ishita-parekh/EMGControlledHandExoskeleton/README.md

# EMGControlledHandExoskeleton
EMG controlled hand exoskeleton for rehabilitation of patients recovering from accidents or stroke

#Demonstartion youtube link: https://youtu.be/TVKU1VpVG2Y
