ishita-parekh/EMGControlledHandExoskeleton/Final_Hand_Exo/pusher-125mm-long.STL

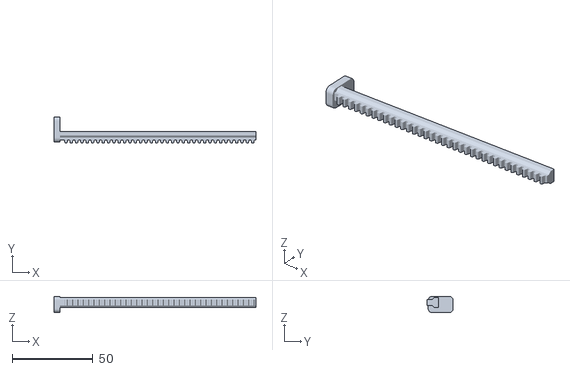
[picture p63: CAD file, 2019-08-11]
Final_Hand_Exo/pusher-125mm-long.STL
125.0 x 16.3 x 10.2
