ishita-parekh/EMGControlledHandExoskeleton/Final_Hand_Exo/RingFinger_LastBit.stl

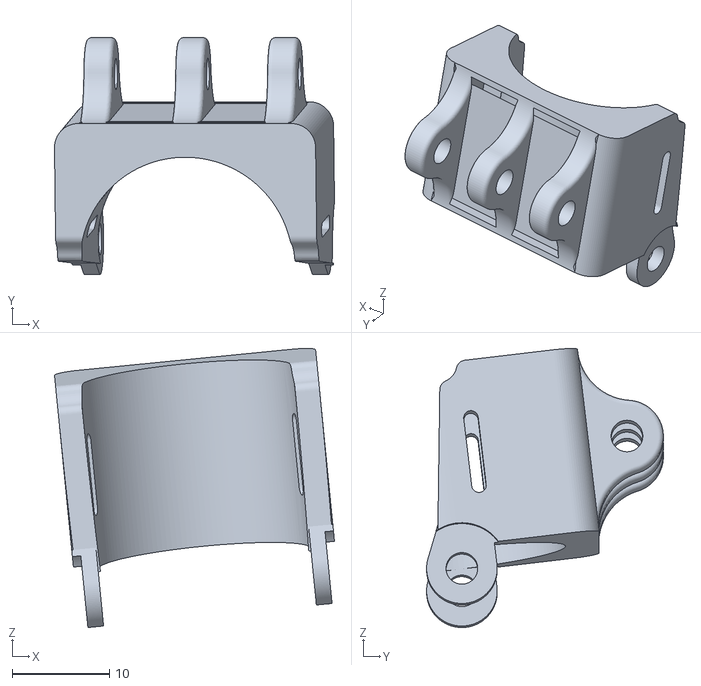
[picture p64: CAD file, 2019-08-11]
Final_Hand_Exo/RingFinger_LastBit.stl
28.8 x 24.4 x 28.7
