ishita-parekh/EMGControlledHandExoskeleton/Final_Hand_Exo/Back_HAnd_BAse_LittleFinger.stl

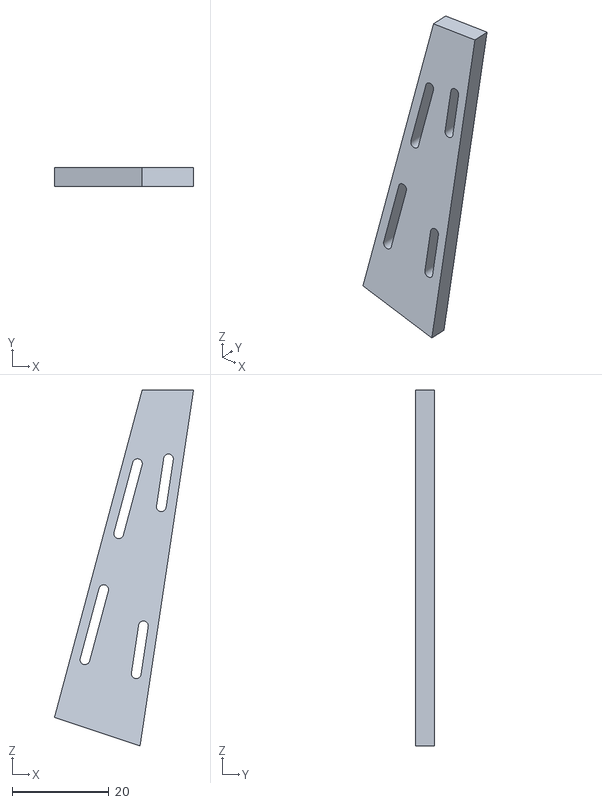
[picture p65: CAD file, 2019-08-11]
Final_Hand_Exo/Back_HAnd_BAse_LittleFinger.stl
28.7 x 4.00 x 73.5
