ishita-parekh/EMGControlledHandExoskeleton/Final_Hand_Exo/IndexFinger_Large4BarConnector.stl

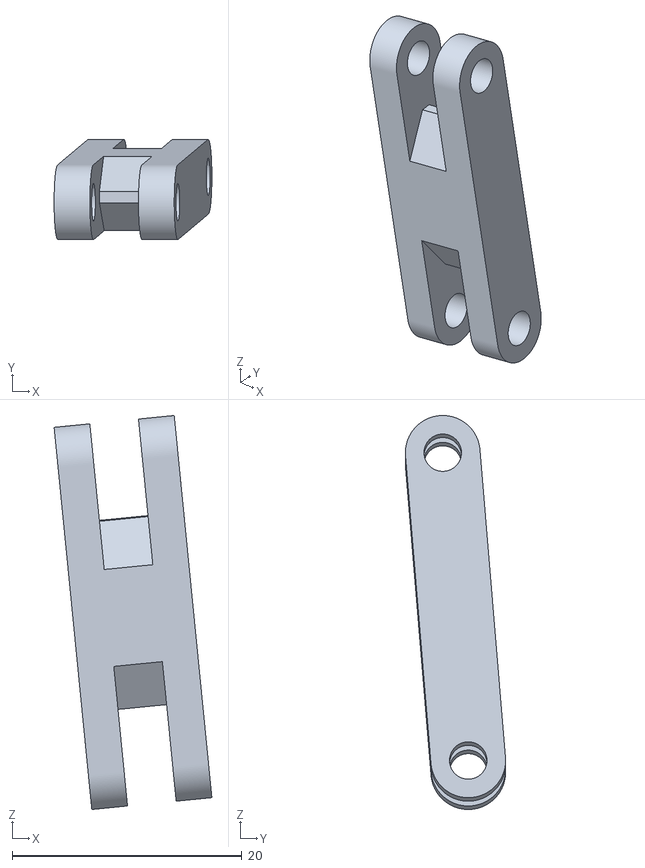
[picture p66: CAD file, 2019-08-11]
Final_Hand_Exo/IndexFinger_Large4BarConnector.stl
13.7 x 8.72 x 34.3
