ishita-parekh/EMGControlledHandExoskeleton/Final_Hand_Exo/RingFinger_FourBarConnector1.stl

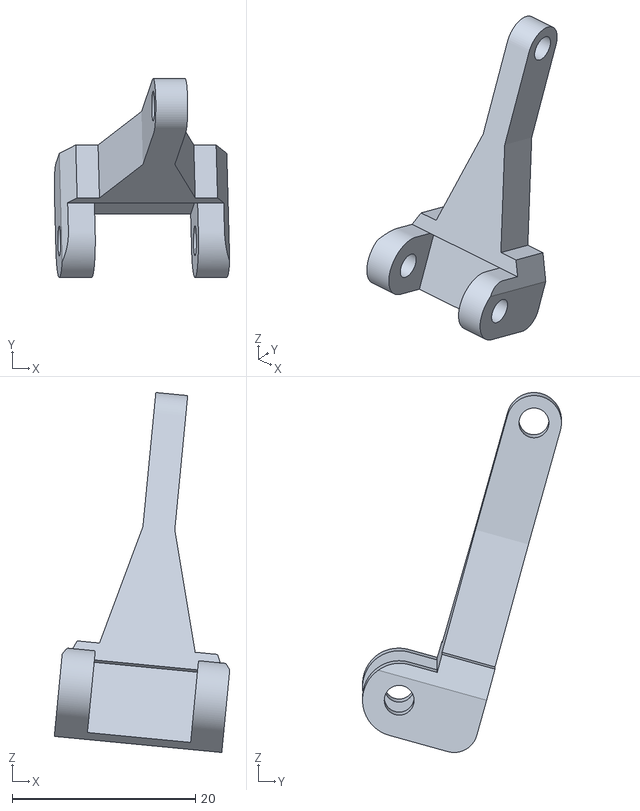
[picture p67: CAD file, 2019-08-11]
Final_Hand_Exo/RingFinger_FourBarConnector1.stl
19.2 x 21.7 x 39.3
