ishita-parekh/EMGControlledHandExoskeleton/Final_Hand_Exo/MiddleFinger_4BarConnectorLarge.stl

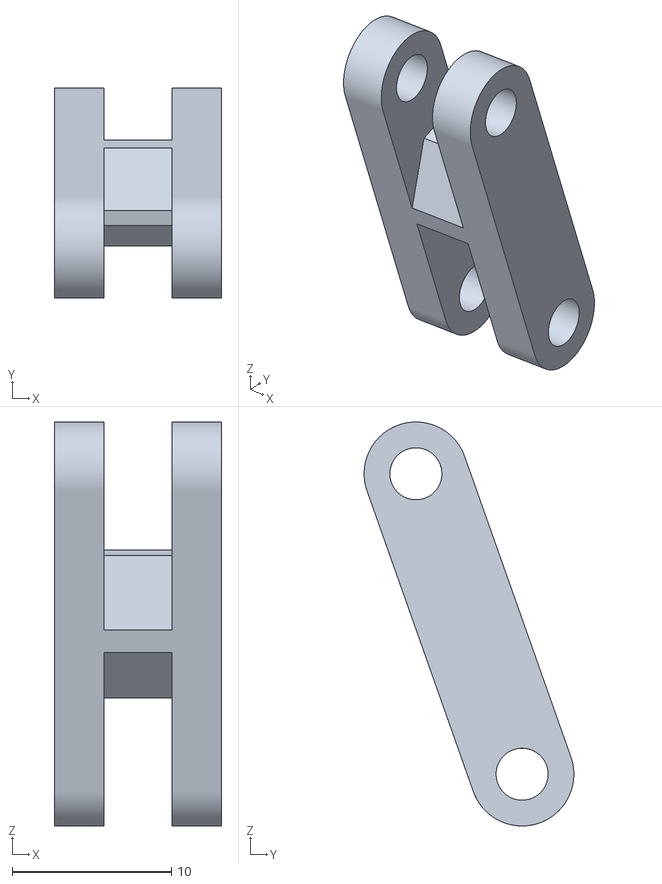
[picture p68: CAD file, 2019-08-11]
Final_Hand_Exo/MiddleFinger_4BarConnectorLarge.stl
10.5 x 13.2 x 25.4
