ishita-parekh/EMGControlledHandExoskeleton/Final_Hand_Exo/LittleFinger_LAstBit.stl

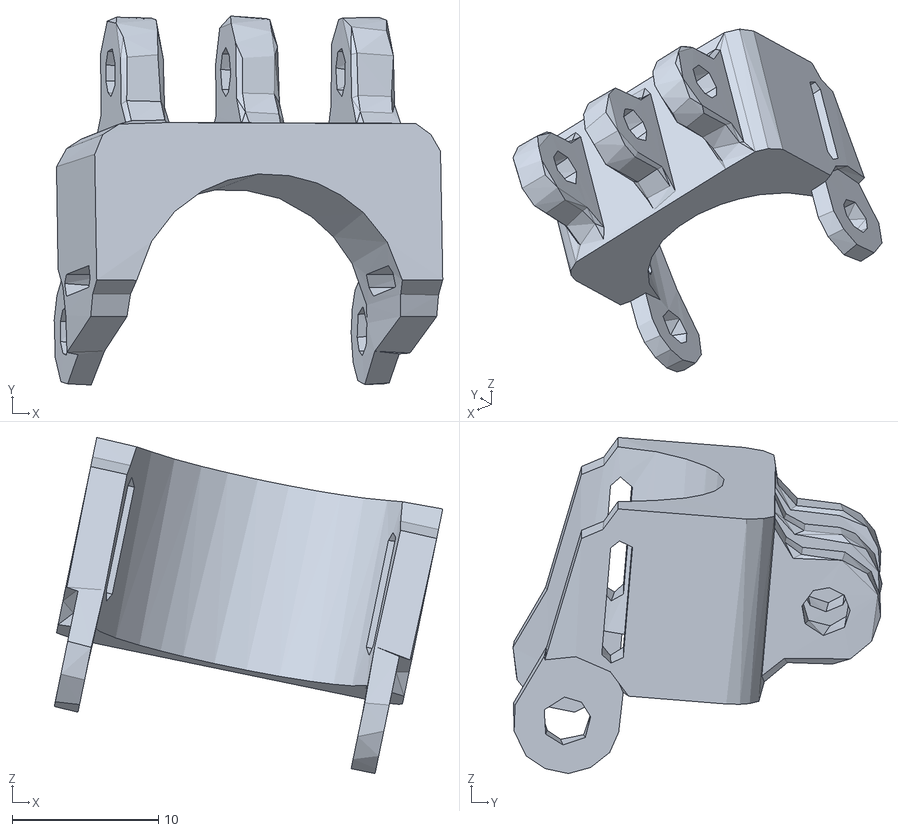
[picture p69: CAD file, 2019-08-11]
Final_Hand_Exo/LittleFinger_LAstBit.stl
26.6 x 25.3 x 23.0
