ishita-parekh/EMGControlledHandExoskeleton/Final_Hand_Exo/IndexFinger_fourBarConnector.stl

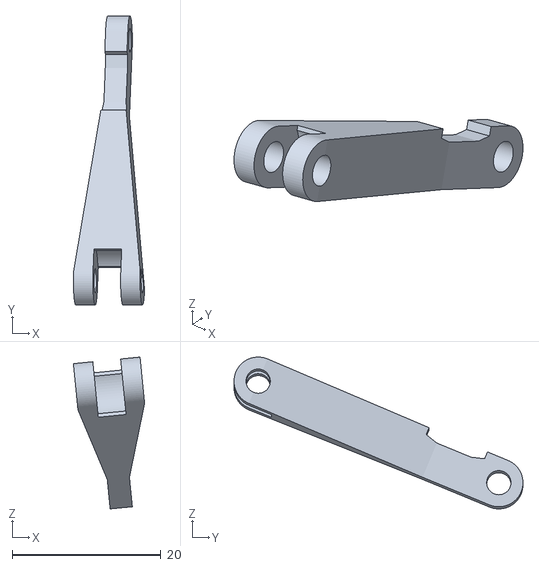
[picture p70: CAD file, 2019-08-11]
Final_Hand_Exo/IndexFinger_fourBarConnector.stl
9.57 x 38.8 x 20.4
