ishita-parekh/EMGControlledHandExoskeleton/Final_Hand_Exo/MiddleFinger_TipBit.stl

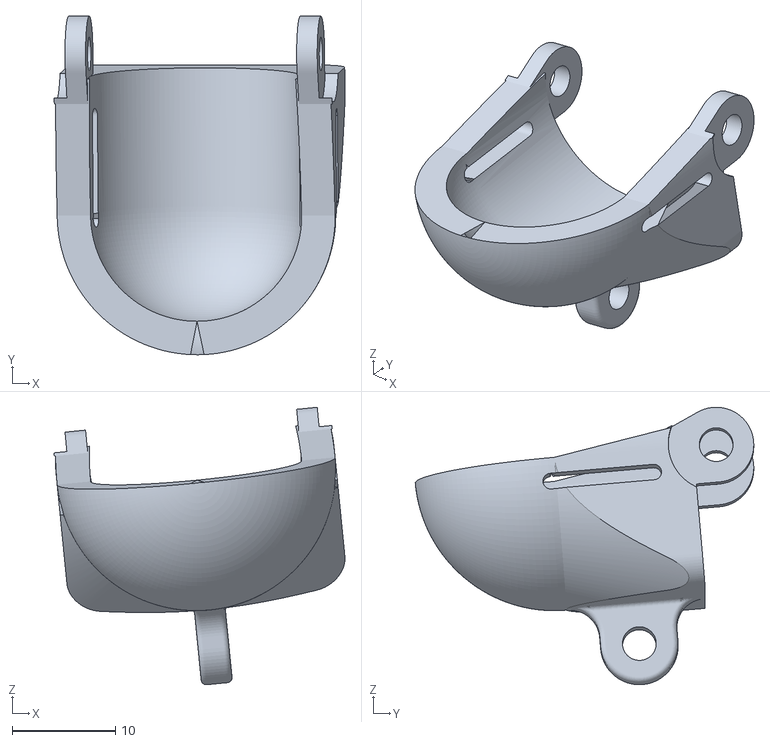
[picture p71: CAD file, 2019-08-11]
Final_Hand_Exo/MiddleFinger_TipBit.stl
28.1 x 32.7 x 26.8
