ishita-parekh/EMGControlledHandExoskeleton/Final_Hand_Exo/MiddleFinger_CentralBit.stl

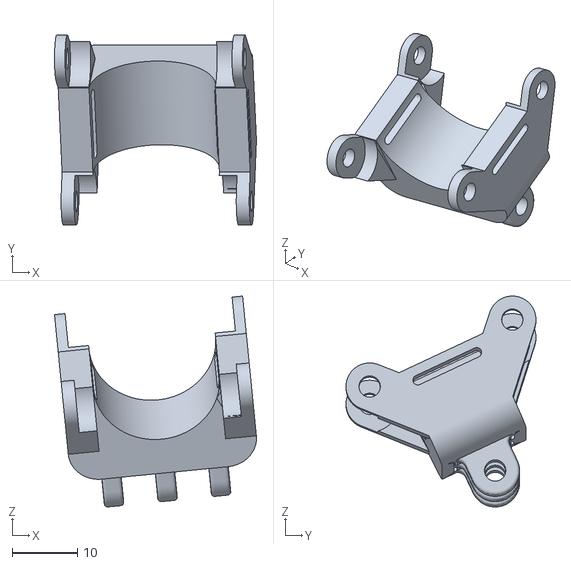
[picture p72: CAD file, 2019-08-11]
Final_Hand_Exo/MiddleFinger_CentralBit.stl
31.0 x 29.2 x 32.4
