ishita-parekh/EMGControlledHandExoskeleton/Final_Hand_Exo/IndexFinger_4BarConnector1.stl

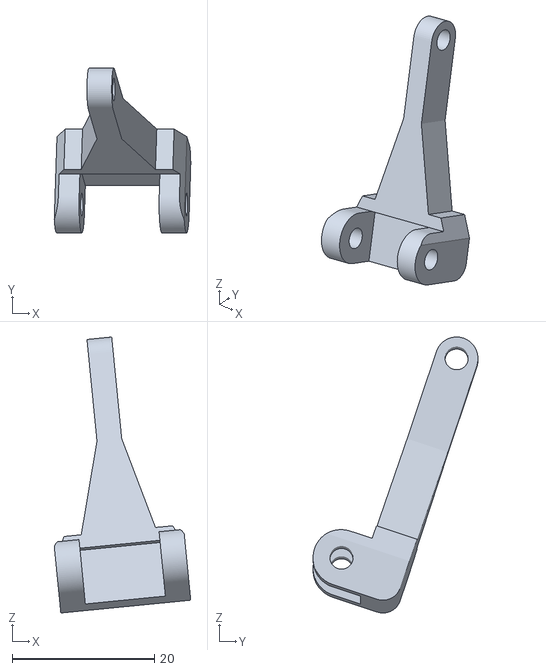
[picture p73: CAD file, 2019-08-11]
Final_Hand_Exo/IndexFinger_4BarConnector1.stl
19.2 x 23.2 x 38.8
