ishita-parekh/EMGControlledHandExoskeleton/Final_Hand_Exo/MiddleFinger_FourBarConnector.stl

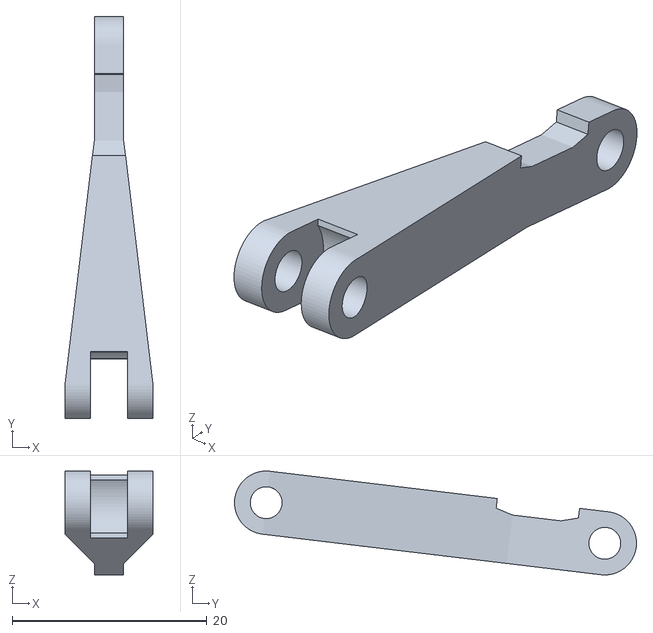
[picture p74: CAD file, 2019-08-11]
Final_Hand_Exo/MiddleFinger_FourBarConnector.stl
9.00 x 41.2 x 10.7
