ishita-parekh/EMGControlledHandExoskeleton/Final_Hand_Exo/Bar_HolderLastBit.stl

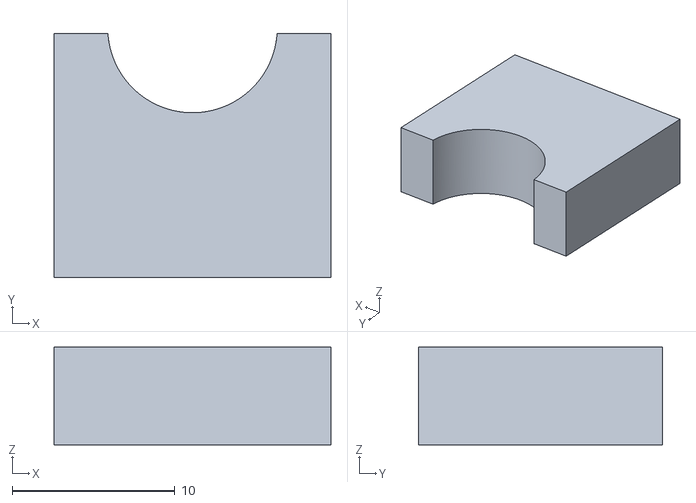
[picture p75: CAD file, 2019-08-11]
Final_Hand_Exo/Bar_HolderLastBit.stl
17.0 x 15.0 x 6.00
