ishita-parekh/EMGControlledHandExoskeleton/Final_Hand_Exo/LittleFinger_FourBArConnector1.stl

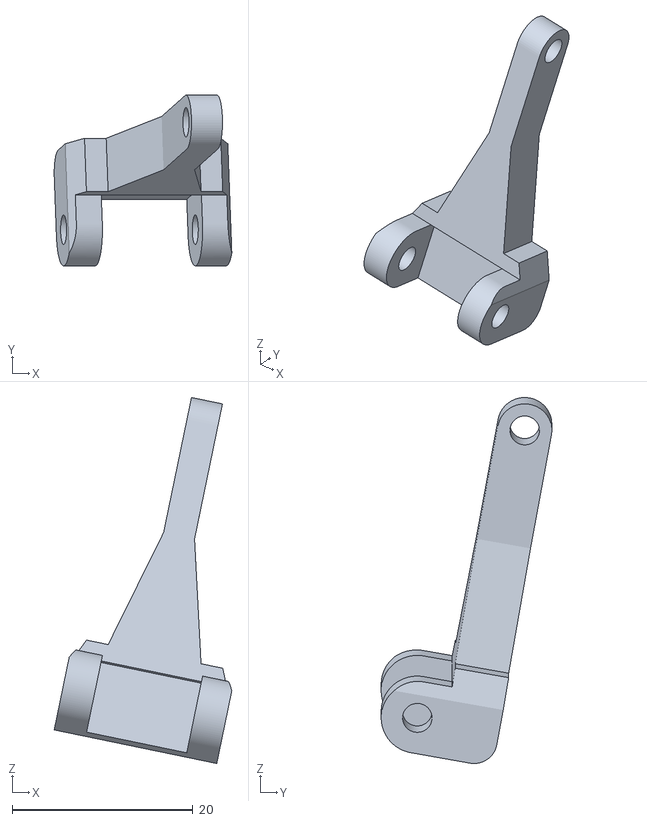
[picture p76: CAD file, 2019-08-11]
Final_Hand_Exo/LittleFinger_FourBArConnector1.stl
19.7 x 18.9 x 40.5
