ishita-parekh/EMGControlledHandExoskeleton/Final_Hand_Exo/Moto_To_ExoConnector.stl

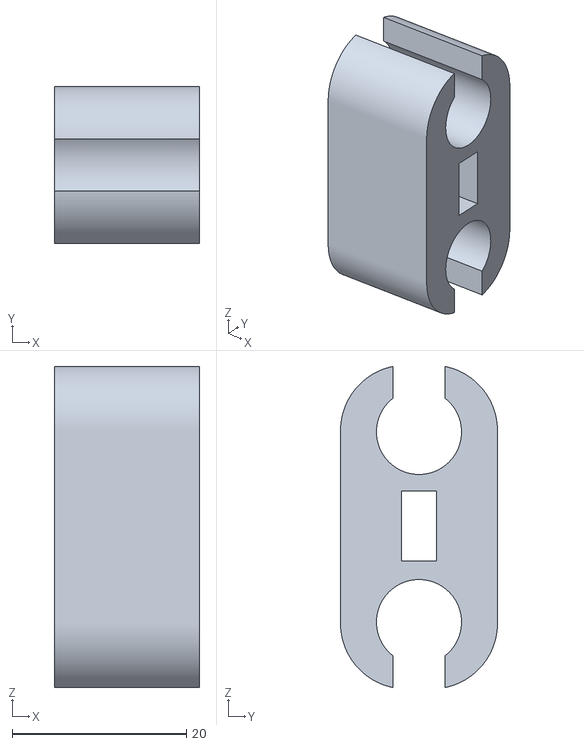
[picture p77: CAD file, 2019-08-11]
Final_Hand_Exo/Moto_To_ExoConnector.stl
16.7 x 18.0 x 36.8
