ishita-parekh/EMGControlledHandExoskeleton/Final_Hand_Exo/Outer_Rod.stl

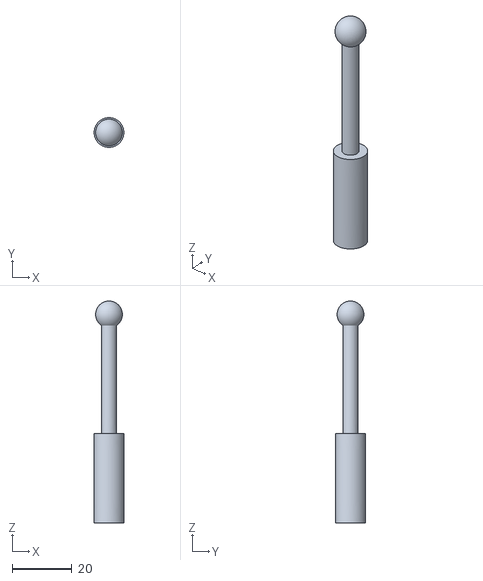
[picture p78: CAD file, 2019-08-11]
Final_Hand_Exo/Outer_Rod.stl
10.0 x 10.00 x 74.5
