ishita-parekh/EMGControlledHandExoskeleton/Final_Hand_Exo/pinion-gear-mini-version.STL

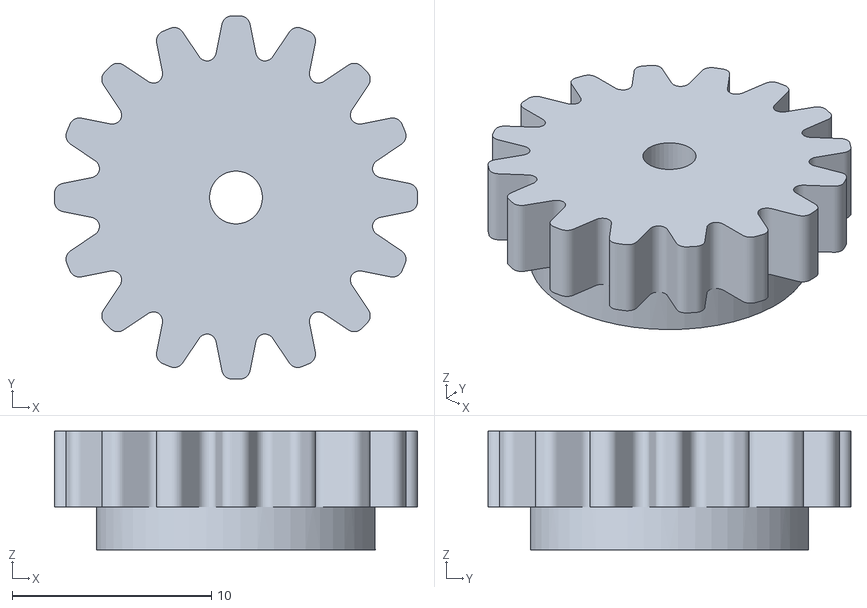
[picture p79: CAD file, 2019-08-11]
Final_Hand_Exo/pinion-gear-mini-version.STL
18.2 x 18.2 x 5.97
