ishita-parekh/EMGControlledHandExoskeleton/Final_Hand_Exo/RingFinger_FourBarConnectorMid.stl

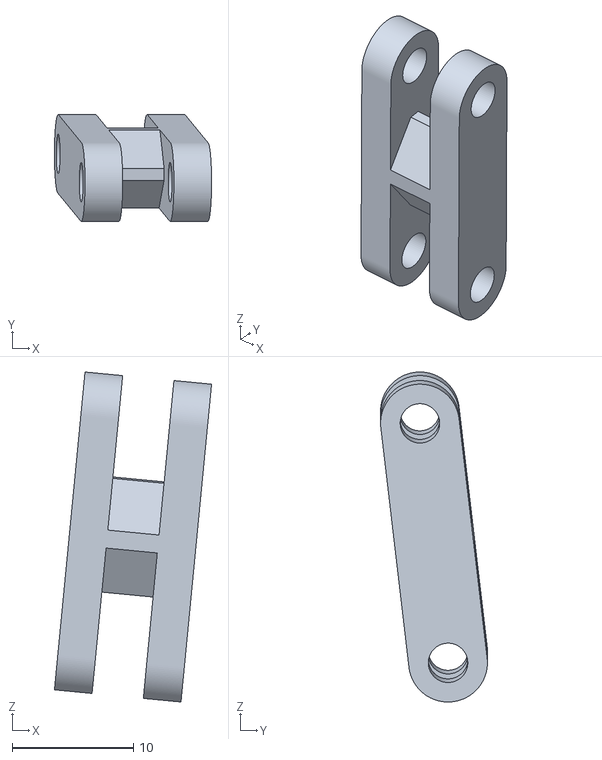
[picture p80: CAD file, 2019-08-11]
Final_Hand_Exo/RingFinger_FourBarConnectorMid.stl
13.0 x 8.82 x 27.2
