ishita-parekh/EMGControlledHandExoskeleton/Final_Hand_Exo/LittleFinger_TipBit.stl

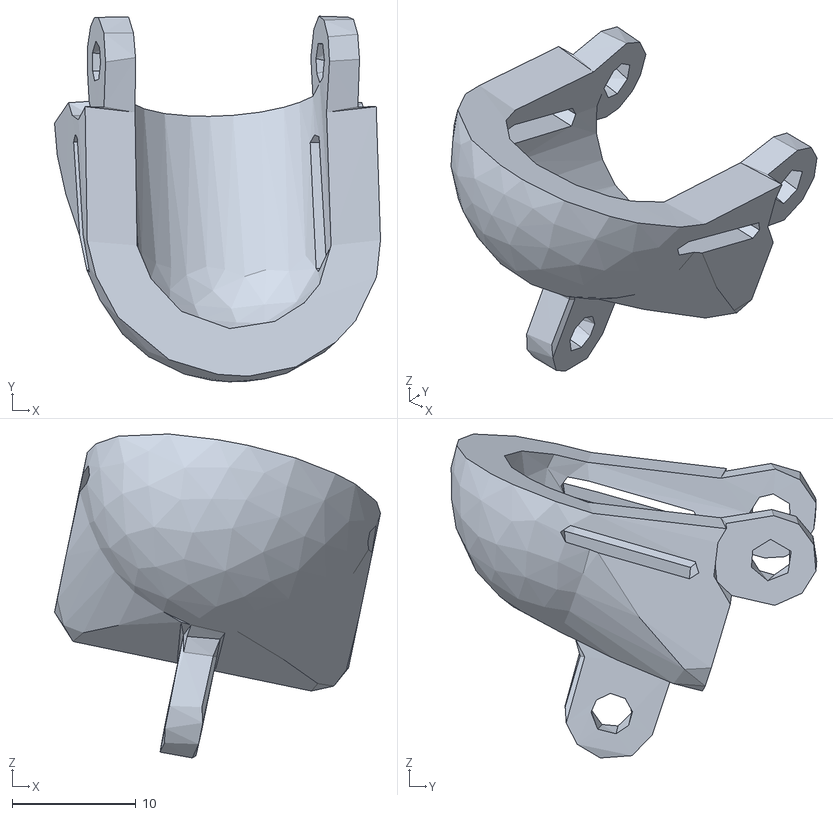
[picture p81: CAD file, 2019-08-11]
Final_Hand_Exo/LittleFinger_TipBit.stl
26.3 x 29.5 x 26.2
