ishita-parekh/EMGControlledHandExoskeleton/Final_Hand_Exo/MiddleFinger_4BarConnector1.stl

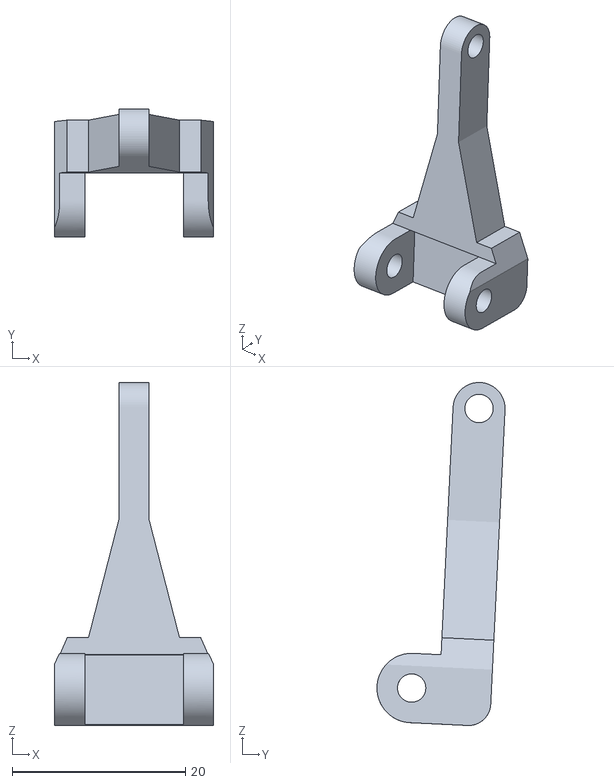
[picture p82: CAD file, 2019-08-11]
Final_Hand_Exo/MiddleFinger_4BarConnector1.stl
18.4 x 14.8 x 39.5
