ishita-parekh/EMGControlledHandExoskeleton/Final_Hand_Exo/Back_of_Hand_Bar_Connector.stl

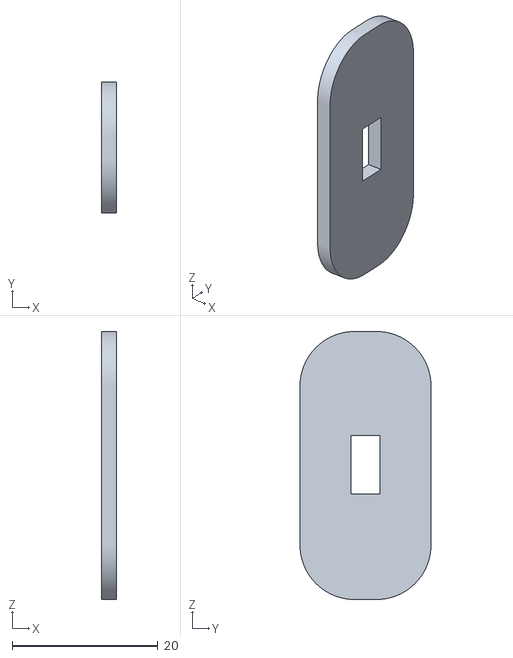
[picture p83: CAD file, 2019-08-11]
Final_Hand_Exo/Back_of_Hand_Bar_Connector.stl
2.10 x 18.0 x 36.8
