ishita-parekh/EMGControlledHandExoskeleton/Final_Hand_Exo/Bar_Holder_Tip_Bit.stl

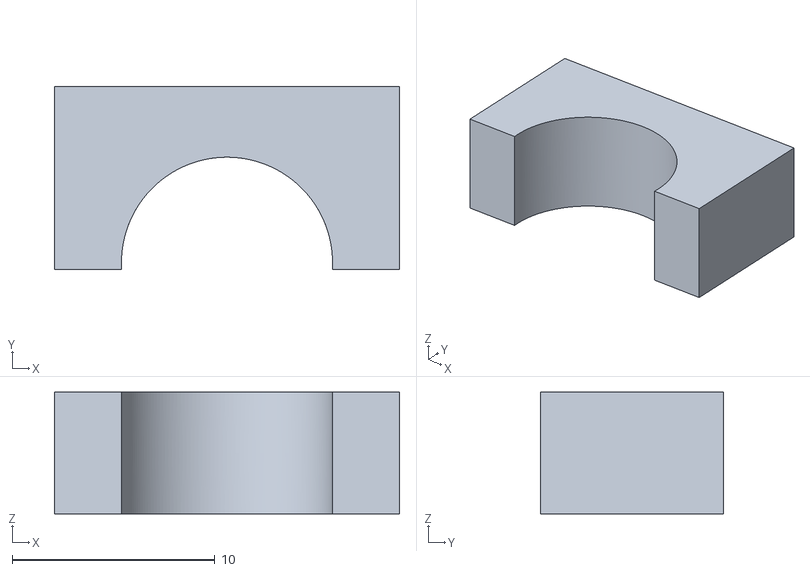
[picture p84: CAD file, 2019-08-11]
Final_Hand_Exo/Bar_Holder_Tip_Bit.stl
17.0 x 9.00 x 6.00
