ishita-parekh/EMGControlledHandExoskeleton/Final_Hand_Exo/Back_Hand_Base_RingFinger.stl

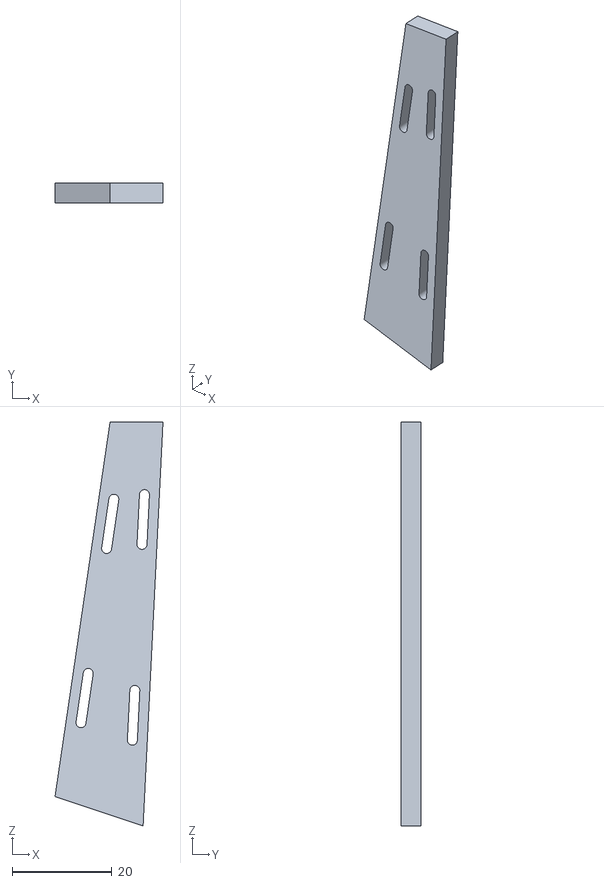
[picture p85: CAD file, 2019-08-11]
Final_Hand_Exo/Back_Hand_Base_RingFinger.stl
21.7 x 4.00 x 81.1
