ishita-parekh/EMGControlledHandExoskeleton/Final_Hand_Exo/MiddleFinger_LastBit.stl

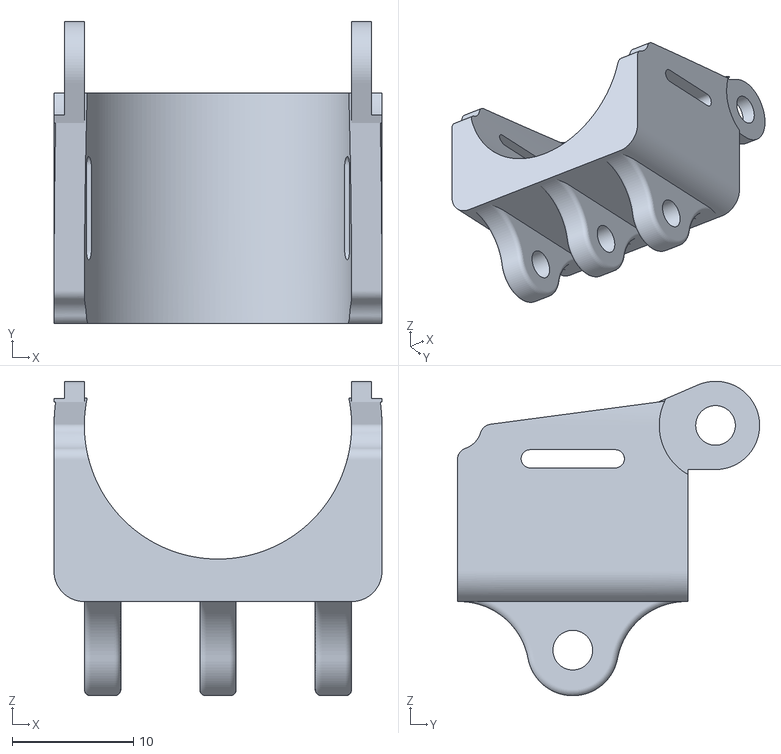
[picture p86: CAD file, 2019-08-11]
Final_Hand_Exo/MiddleFinger_LastBit.stl
27.0 x 24.9 x 25.9
