ishita-parekh/EMGControlledHandExoskeleton/Final_Hand_Exo/IndexFinger_4BarConnector2.stl

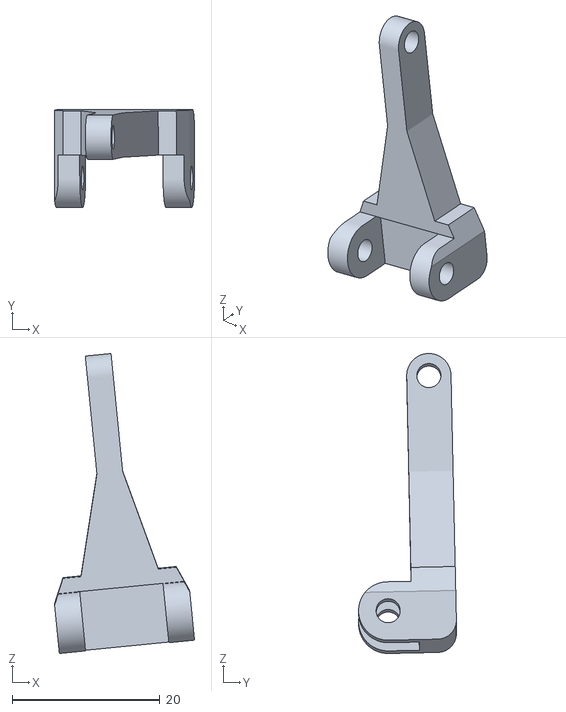
[picture p87: CAD file, 2019-08-11]
Final_Hand_Exo/IndexFinger_4BarConnector2.stl
18.9 x 13.2 x 40.6
