ishita-parekh/EMGControlledHandExoskeleton/Final_Hand_Exo/InnerRod_60mm.stl

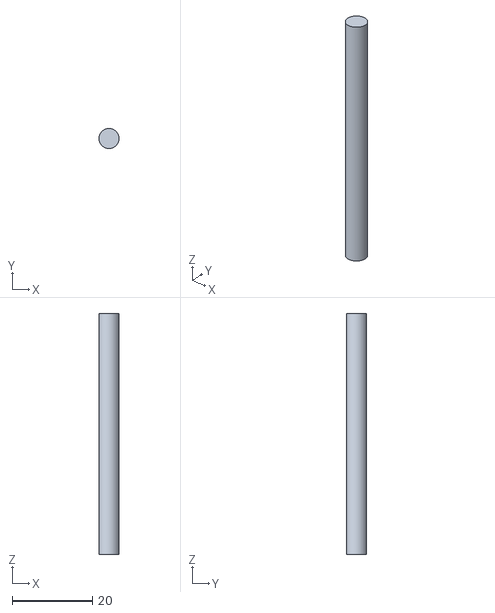
[picture p88: CAD file, 2019-08-11]
Final_Hand_Exo/InnerRod_60mm.stl
5.00 x 5.00 x 60.0
