ishita-parekh/EMGControlledHandExoskeleton/Final_Hand_Exo/FingerConnector.stl

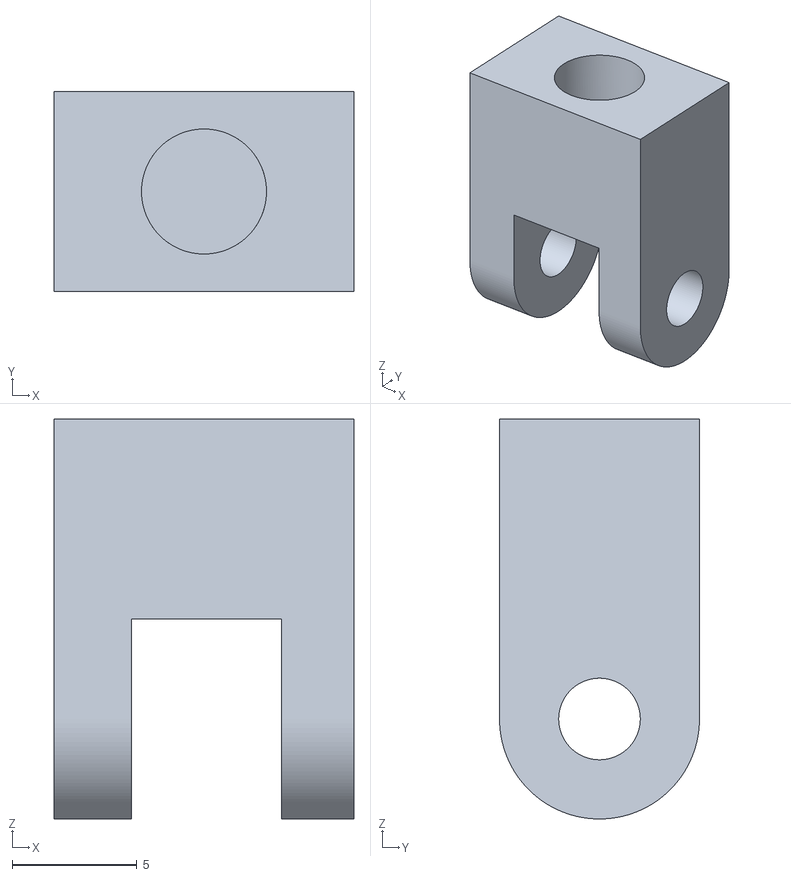
[picture p89: CAD file, 2019-08-11]
Final_Hand_Exo/FingerConnector.stl
12.0 x 8.00 x 16.0
