ishita-parekh/EMGControlledHandExoskeleton/Final_Hand_Exo/LittleFinger_FourBarMidConnector.stl

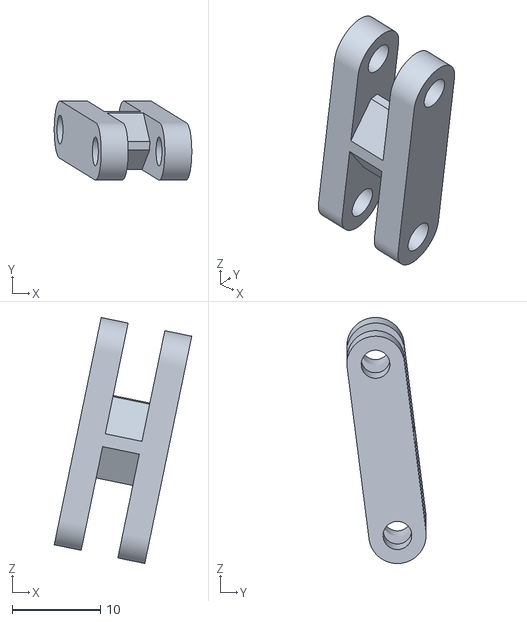
[picture p90: CAD file, 2019-08-11]
Final_Hand_Exo/LittleFinger_FourBarMidConnector.stl
15.6 x 8.98 x 27.9
