ishita-parekh/EMGControlledHandExoskeleton/Final_Hand_Exo/Bar_Holder.stl

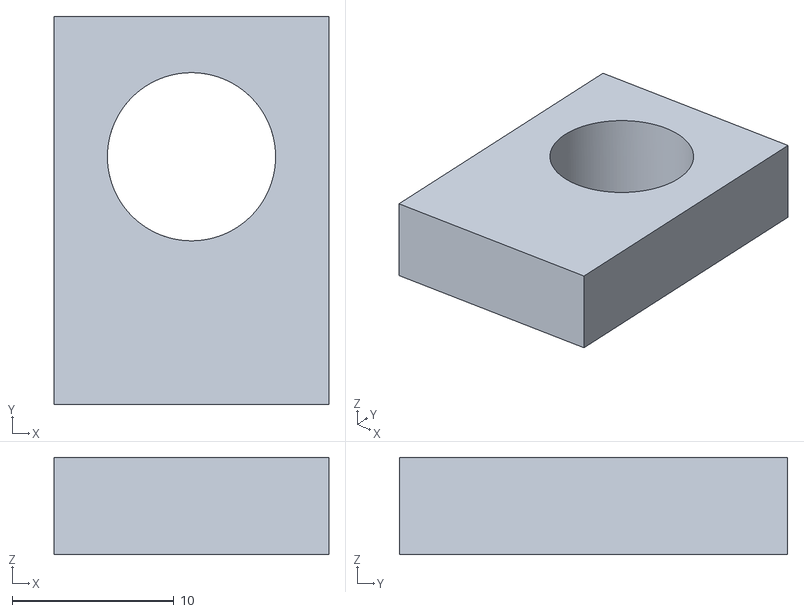
[picture p91: CAD file, 2019-08-11]
Final_Hand_Exo/Bar_Holder.stl
17.0 x 24.0 x 6.00
