ishita-parekh/EMGControlledHandExoskeleton/Final_Hand_Exo/Back_Hand_Base_IndexFinger.stl

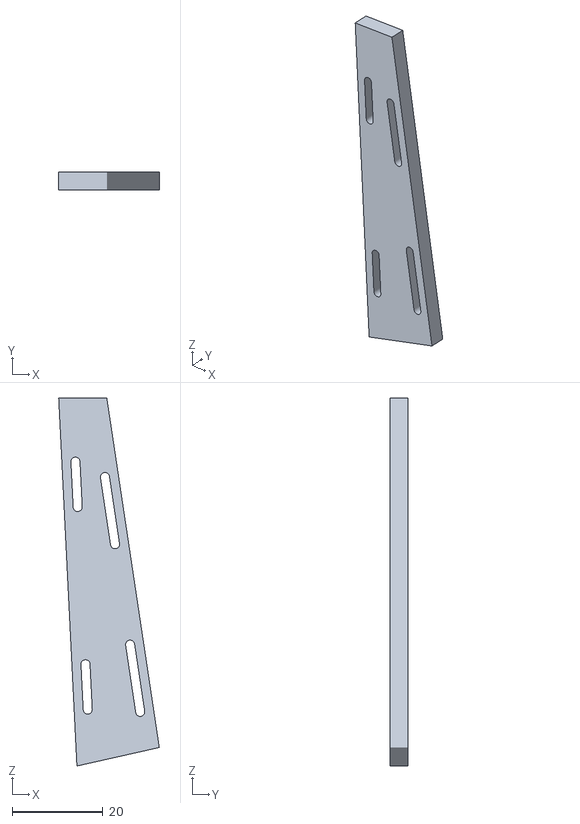
[picture p92: CAD file, 2019-08-11]
Final_Hand_Exo/Back_Hand_Base_IndexFinger.stl
22.2 x 4.00 x 81.2
