ishita-parekh/EMGControlledHandExoskeleton/Final_Hand_Exo/Back_Hand_Base_MiddleFinger.stl

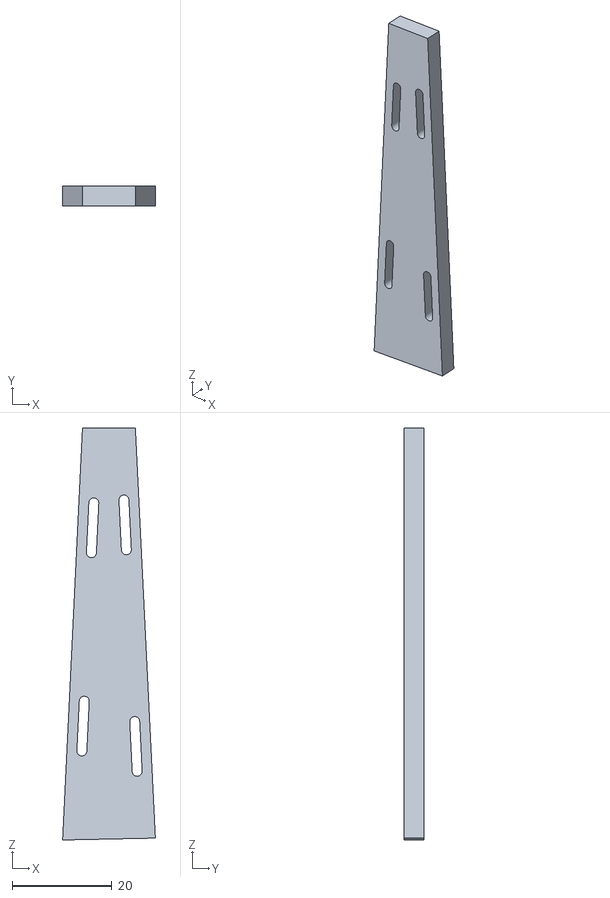
[picture p93: CAD file, 2019-08-11]
Final_Hand_Exo/Back_Hand_Base_MiddleFinger.stl
18.6 x 4.00 x 82.7
