ishita-parekh/EMGControlledHandExoskeleton/Final_Hand_Exo/MiddleFinger_4BarConnector2.stl

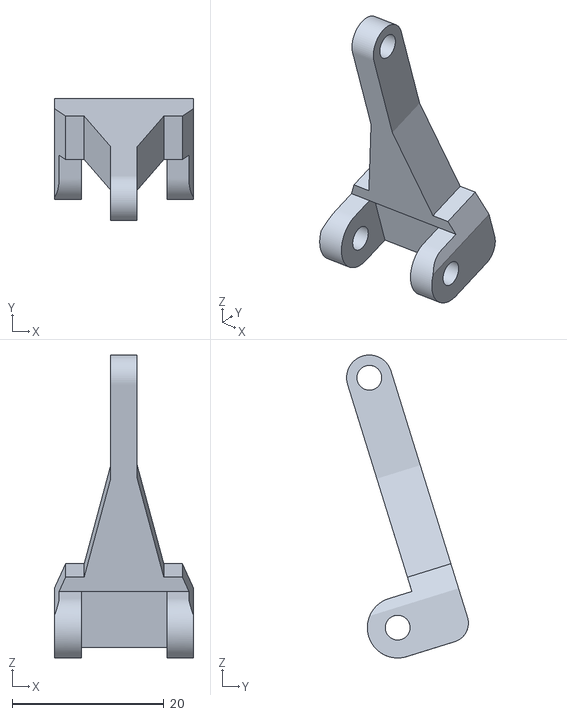
[picture p94: CAD file, 2019-08-11]
Final_Hand_Exo/MiddleFinger_4BarConnector2.stl
18.4 x 16.1 x 39.9
