ishita-parekh/EMGControlledHandExoskeleton/Final_Hand_Exo/Inner_Rod.stl

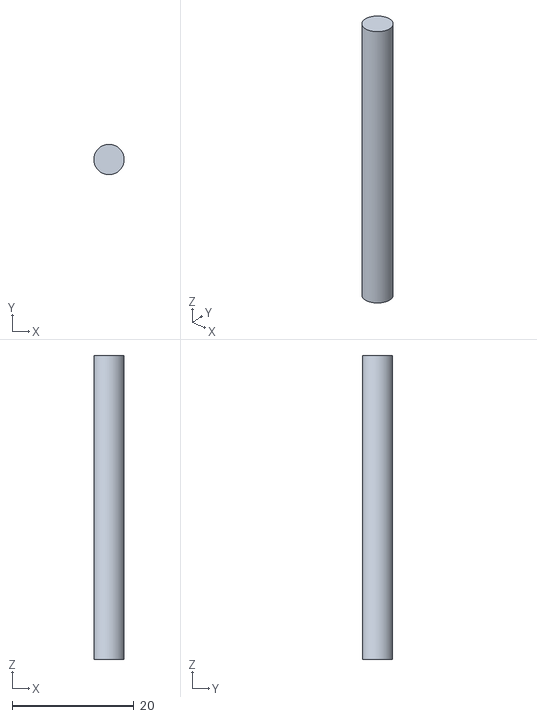
[picture p95: CAD file, 2019-08-11]
Final_Hand_Exo/Inner_Rod.stl
5.00 x 4.99 x 50.0
