ishita-parekh/EMGControlledHandExoskeleton/Final_Hand_Exo/pusher-150mm-long.STL

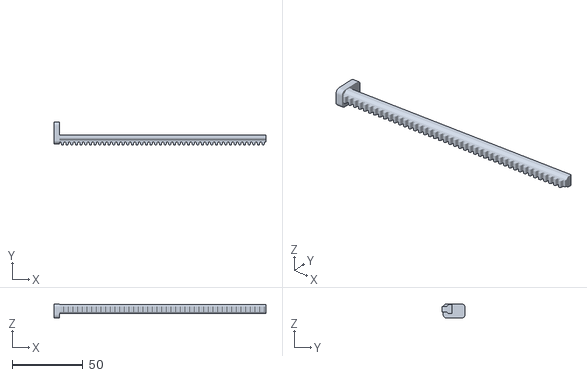
[picture p96: CAD file, 2019-08-11]
Final_Hand_Exo/pusher-150mm-long.STL
150.0 x 16.3 x 10.2
