ishita-parekh/EMGControlledHandExoskeleton/Final_Hand_Exo/LittleFinger_FourBarConnector.stl

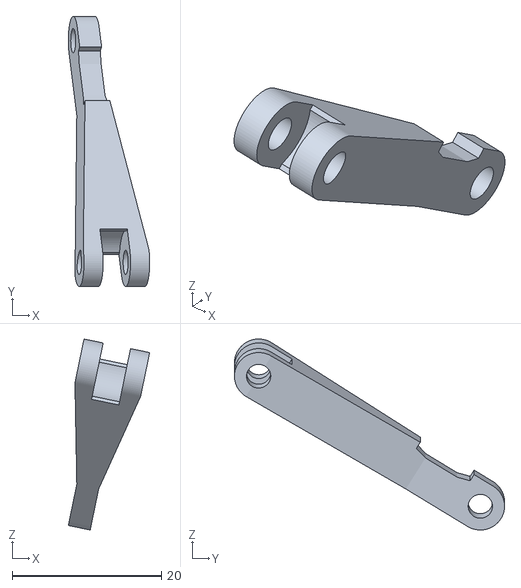
[picture p97: CAD file, 2019-08-11]
Final_Hand_Exo/LittleFinger_FourBarConnector.stl
10.9 x 36.2 x 25.6
