ishita-parekh/EMGControlledHandExoskeleton/Final_Hand_Exo/InnerRod_40mm.stl

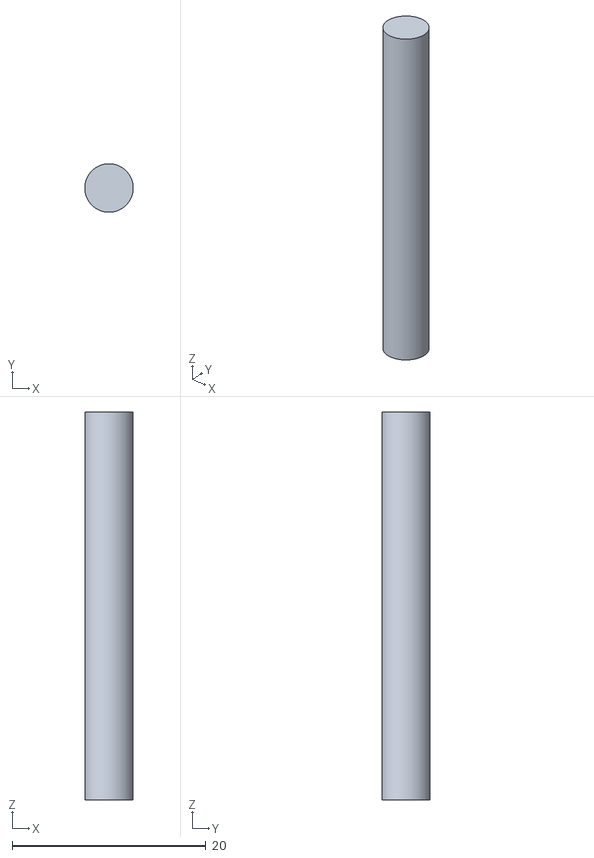
[picture p98: CAD file, 2019-08-11]
Final_Hand_Exo/InnerRod_40mm.stl
5.00 x 5.00 x 40.0
