ishita-parekh/EMGControlledHandExoskeleton/Final_Hand_Exo/LittleFinger_CentralBit.stl

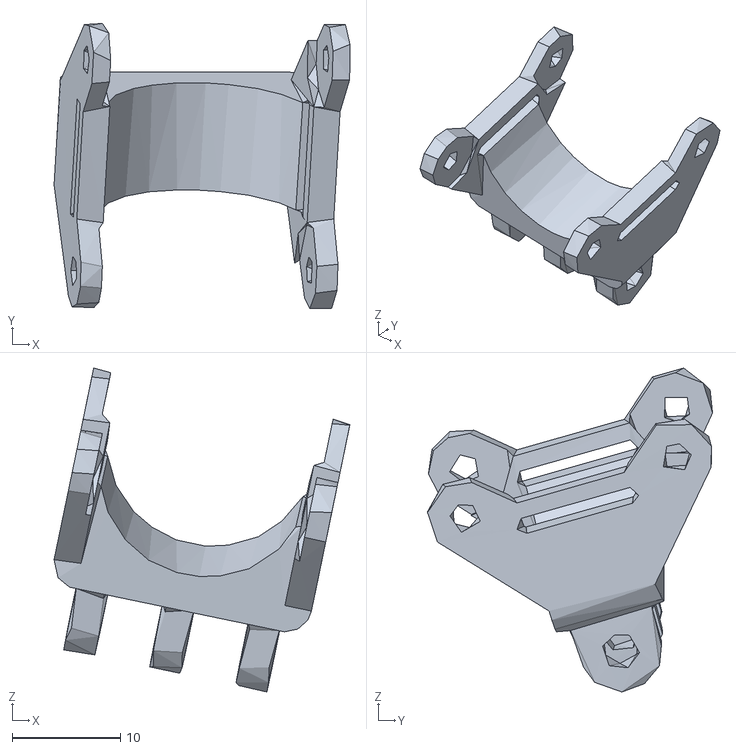
[picture p99: CAD file, 2019-08-11]
Final_Hand_Exo/LittleFinger_CentralBit.stl
27.3 x 26.3 x 29.9
