ishita-parekh/EMGControlledHandExoskeleton/Final_Hand_Exo/IndexFinger_MidFourBarConnector.stl

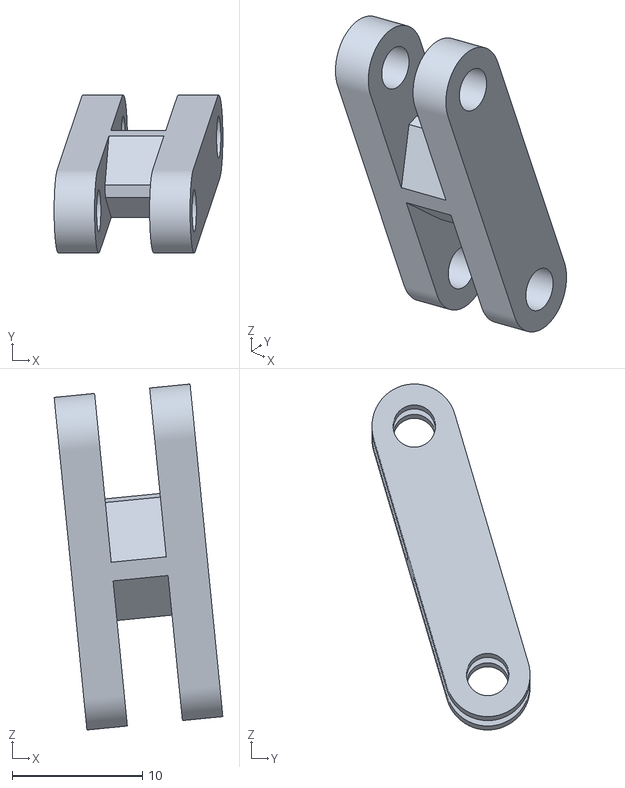
[picture p100: CAD file, 2019-08-11]
Final_Hand_Exo/IndexFinger_MidFourBarConnector.stl
13.0 x 12.1 x 26.6
