ishita-parekh/EMGControlledHandExoskeleton/Final_Hand_Exo/motor-bracket-mini-version.STL

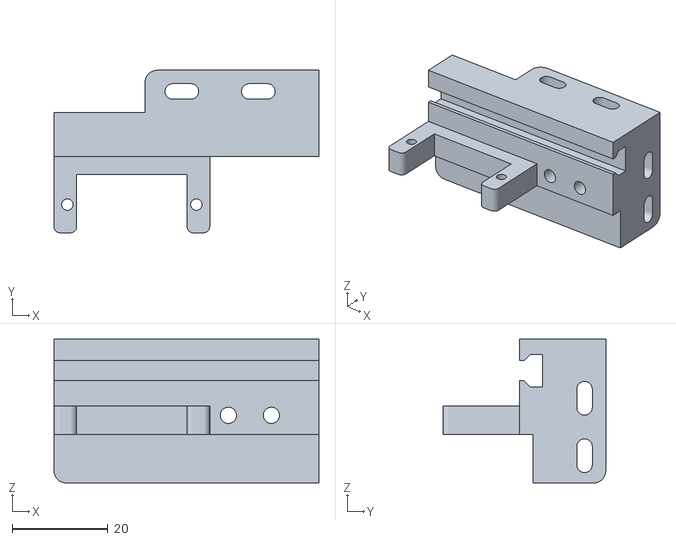
[picture p101: CAD file, 2019-08-11]
Final_Hand_Exo/motor-bracket-mini-version.STL
55.5 x 34.0 x 30.1
