ishita-parekh/EMGControlledHandExoskeleton/(list of files, cad)

Other CAD files:
Final_Hand_Exo/RingFinger_4BarConnector2.stl
