ishita-parekh/EMGControlledHandExoskeleton/(commit log)

2020-03-10 MSc Research and project thesis
    Thesis on 3d printed wearable exoskeleton for hand rehabilitation
2020-03-10 Research paper on 3d printed exoskeleton for hand rehabilitation
